sonicavionics/4in/kicad/modules/backplate/production/bom.csv

Designator | Footprint | Quantity | Value | LCSC Part #
J1_5, J1_4, J1_3, J1_2, J1 | AMPHENOL_10018784-10210TLF | 5 | 10018784-10210TLF
R1, R2 | 0805 | 2 | 120
