sonicavionics/4in/kicad/modules/template/production/bom.csv

Designator | Footprint | Quantity | Value | LCSC Part #
J1 | BUS_PCIexpress_x1 | 1 | Bus_PCI_Express_x1 | n/a
