sonicavionics/4in/kicad/backplate.DXF

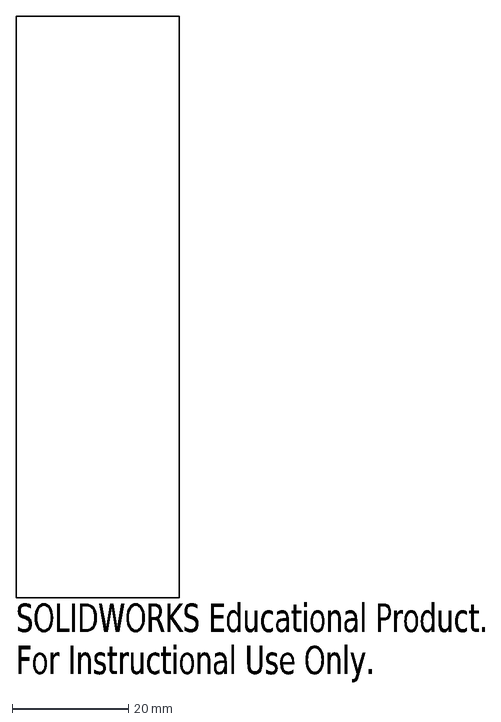
[picture p1: CAD file, 2024-12-09]
kicad/backplate.DXF
SOLIDWORKS Educational Product.
For Instructional Use Only.
