sonicavionics/4in/rack.DXF

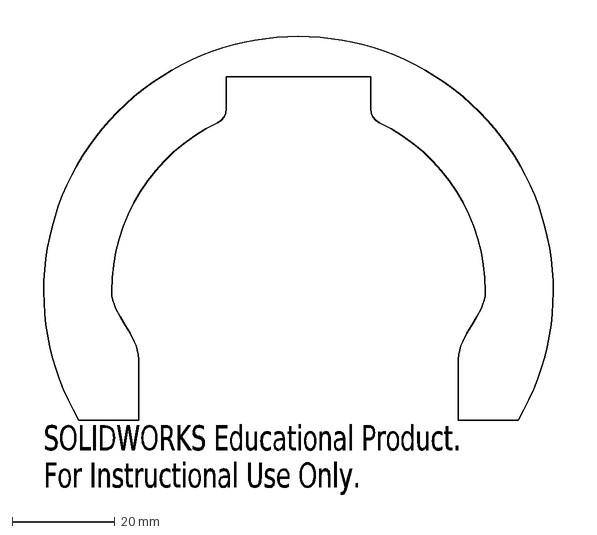
[picture p2: CAD file, 2024-12-08]
rack.DXF
SOLIDWORKS Educational Product.
For Instructional Use Only.
