sonicavionics/4in/kicad/pcb.DXF

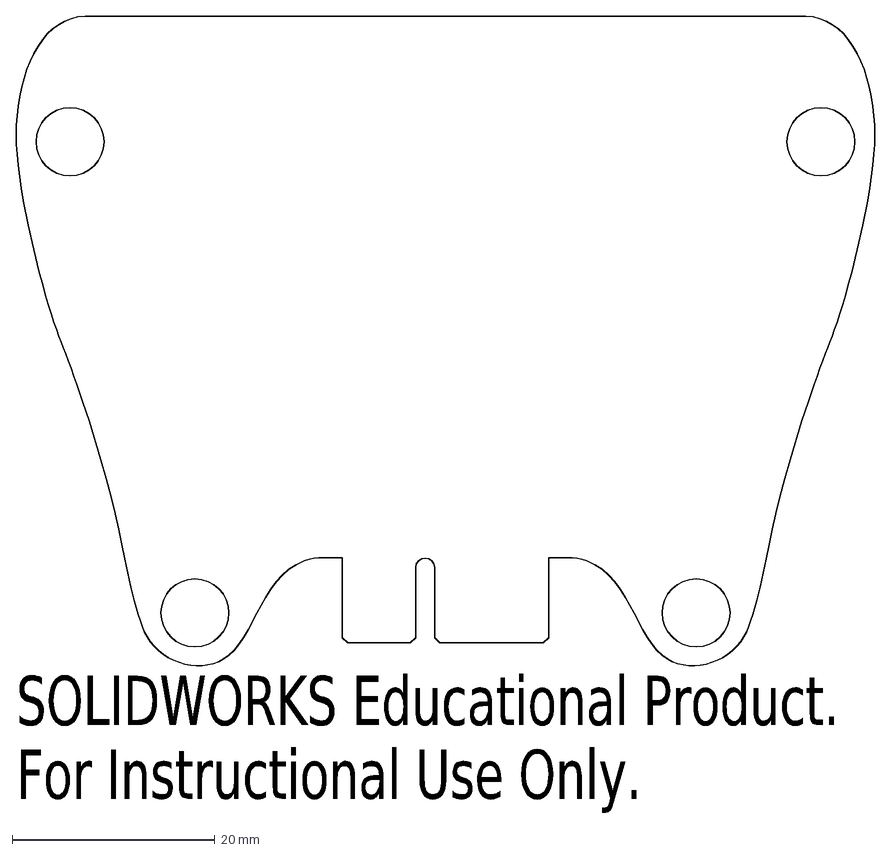
[picture p3: CAD file, 2024-12-09]
kicad/pcb.DXF
SOLIDWORKS Educational Product.
For Instructional Use Only.
