sonicavionics/4in/pcb.DXF

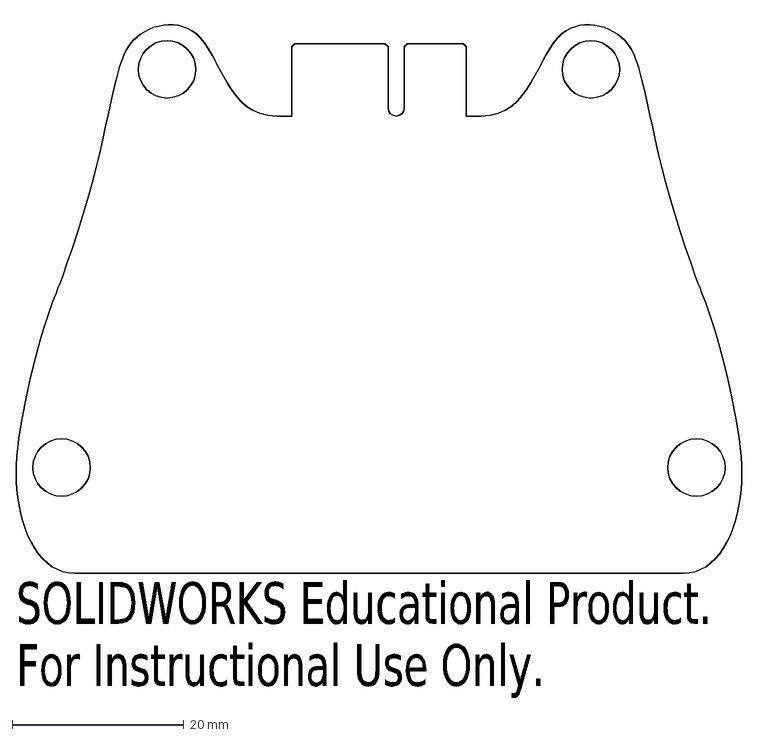
[picture p4: CAD file, 2024-12-08]
pcb.DXF
SOLIDWORKS Educational Product.
For Instructional Use Only.
