sonicavionics/4in/kicad/rack.DXF

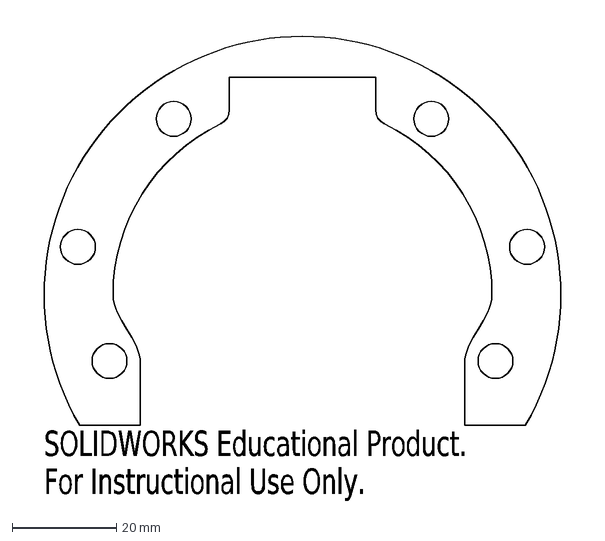
[picture p5: CAD file, 2024-12-09]
kicad/rack.DXF
SOLIDWORKS Educational Product.
For Instructional Use Only.
