sonicavionics/4in/dingboard_solidworks/Assem1.SLDASM

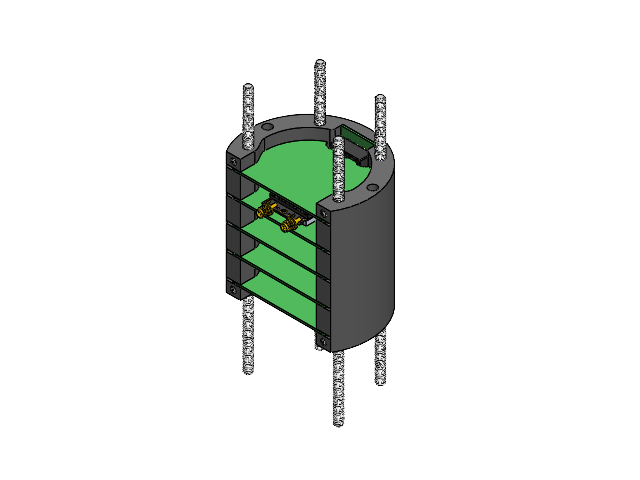
[picture p6: CAD file, 2024-12-08]
dingboard_solidworks/Assem1.SLDASM
board x 5
rack
back_plate
pcie_socket x 5
RFD 900+
insert x 4
3313N126_High-Strength Steel Threaded Rod x 4
