sonicavionics/4in/dingboard_solidworks/Assm.SLDASM

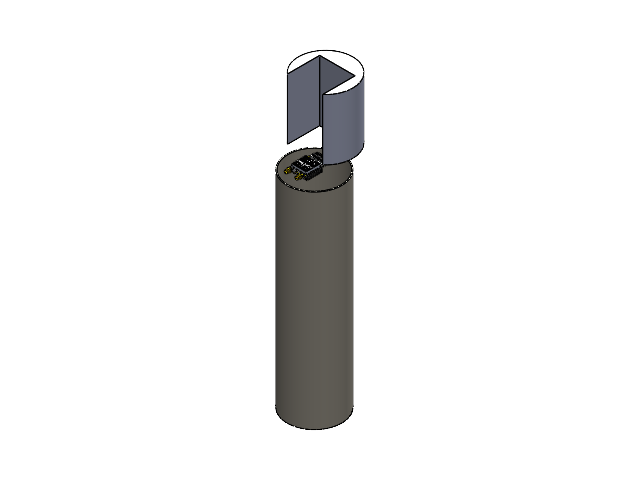
[picture p7: CAD file, 2024-12-04]
dingboard_solidworks/Assm.SLDASM
bipe
RFD 900+
