sonicavionics/4in/kicad/modules/sensors/sensors.kicad_pcb

## KiCad design kicad/modules/sensors/sensors.kicad_pcb (2025-01-03)

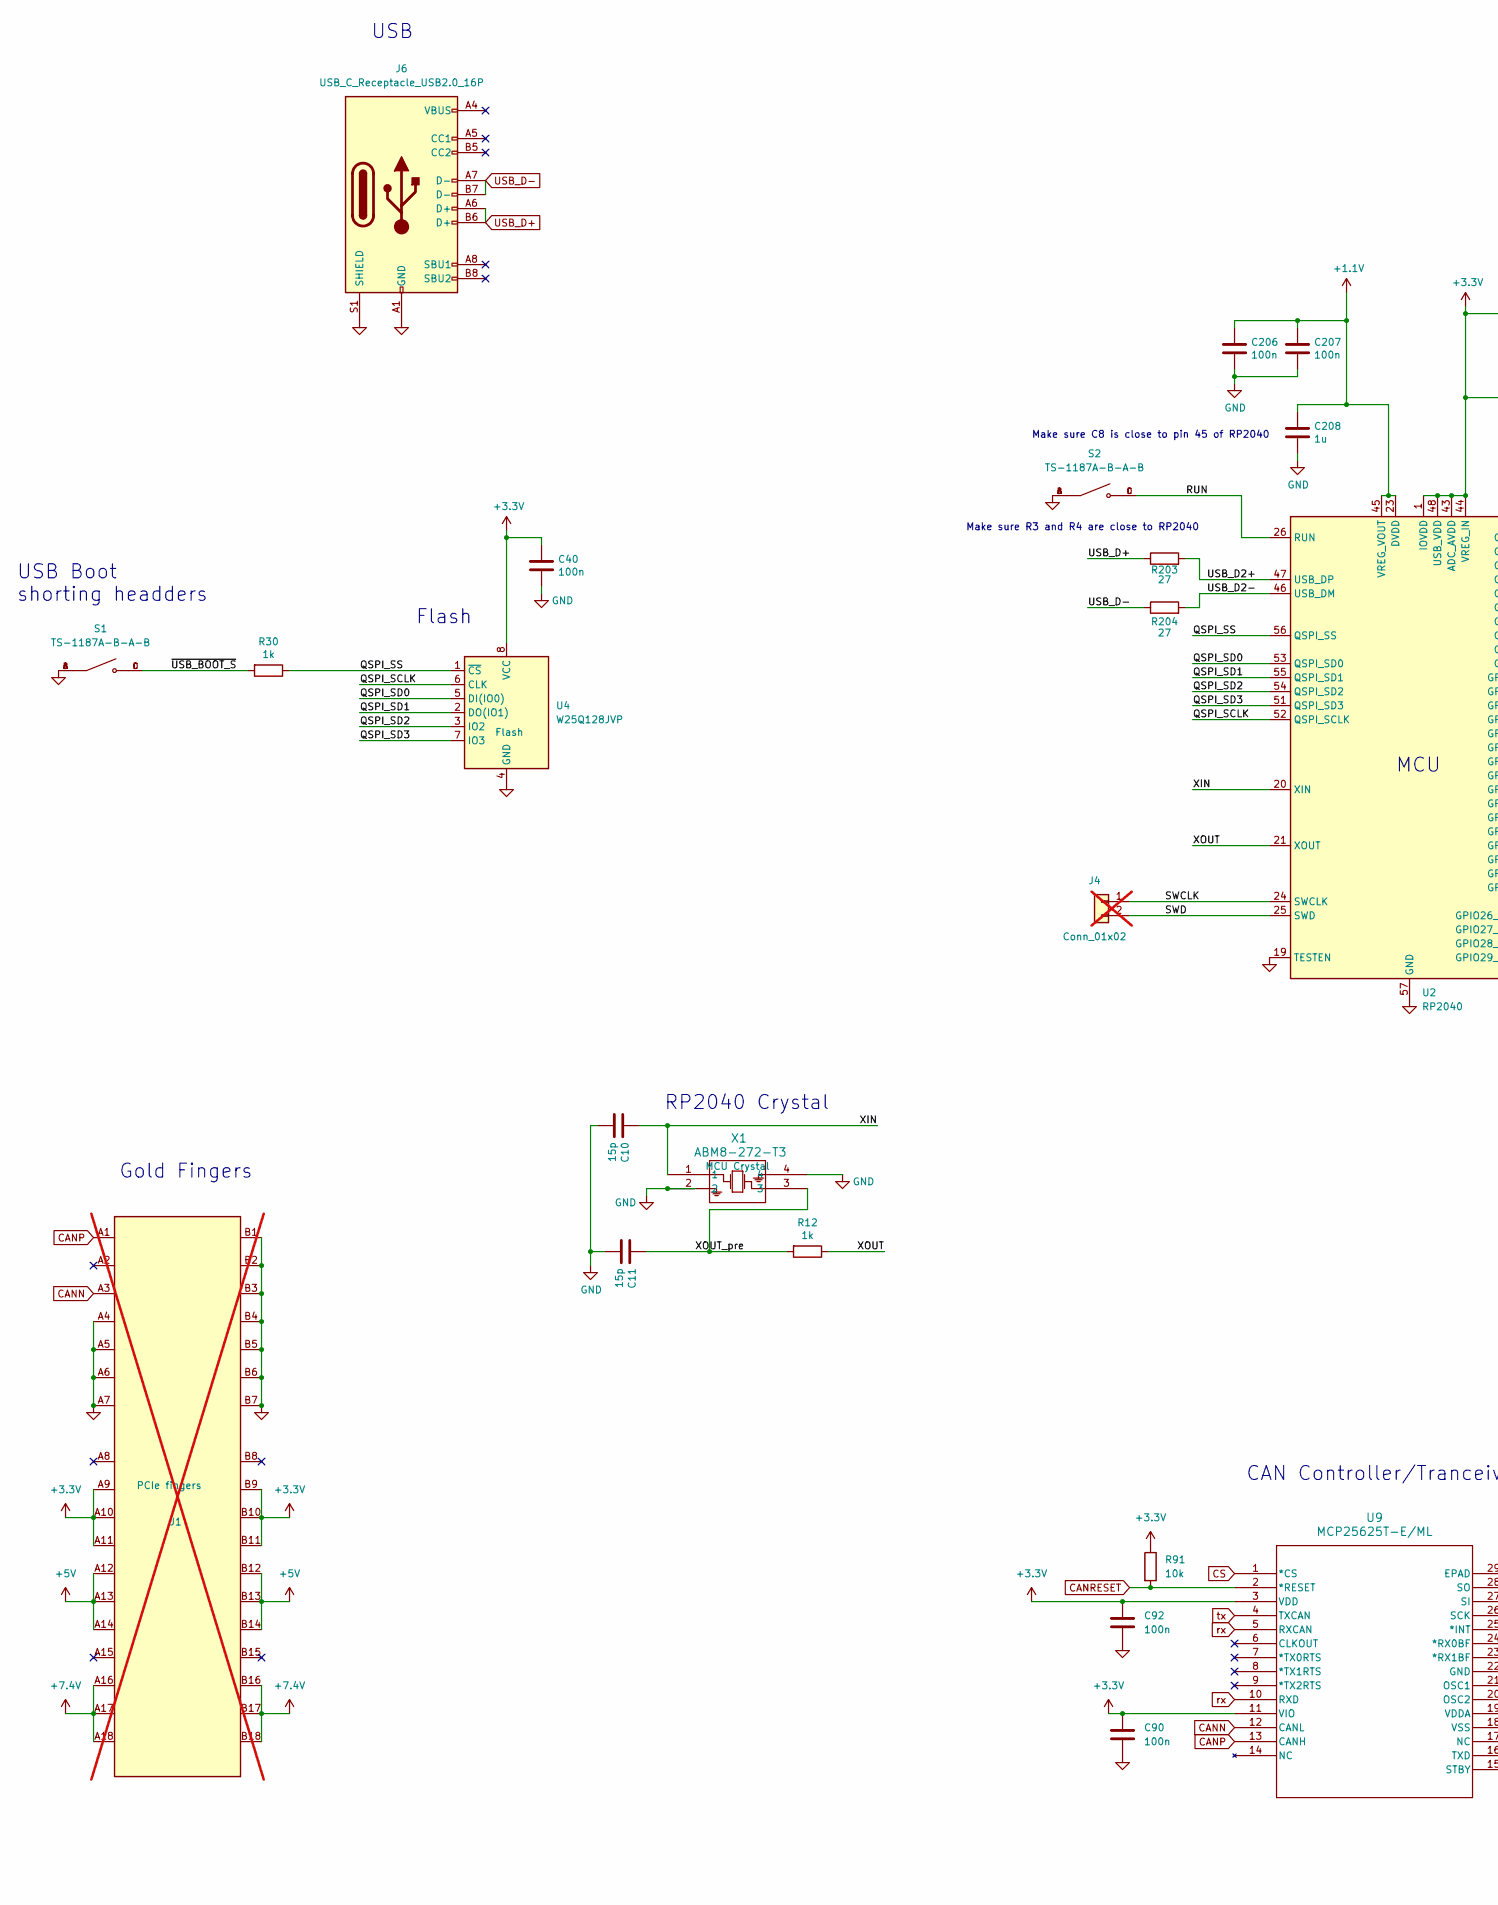
[picture p9: schematic sensors.kicad_sch, part in row 1, column 1]

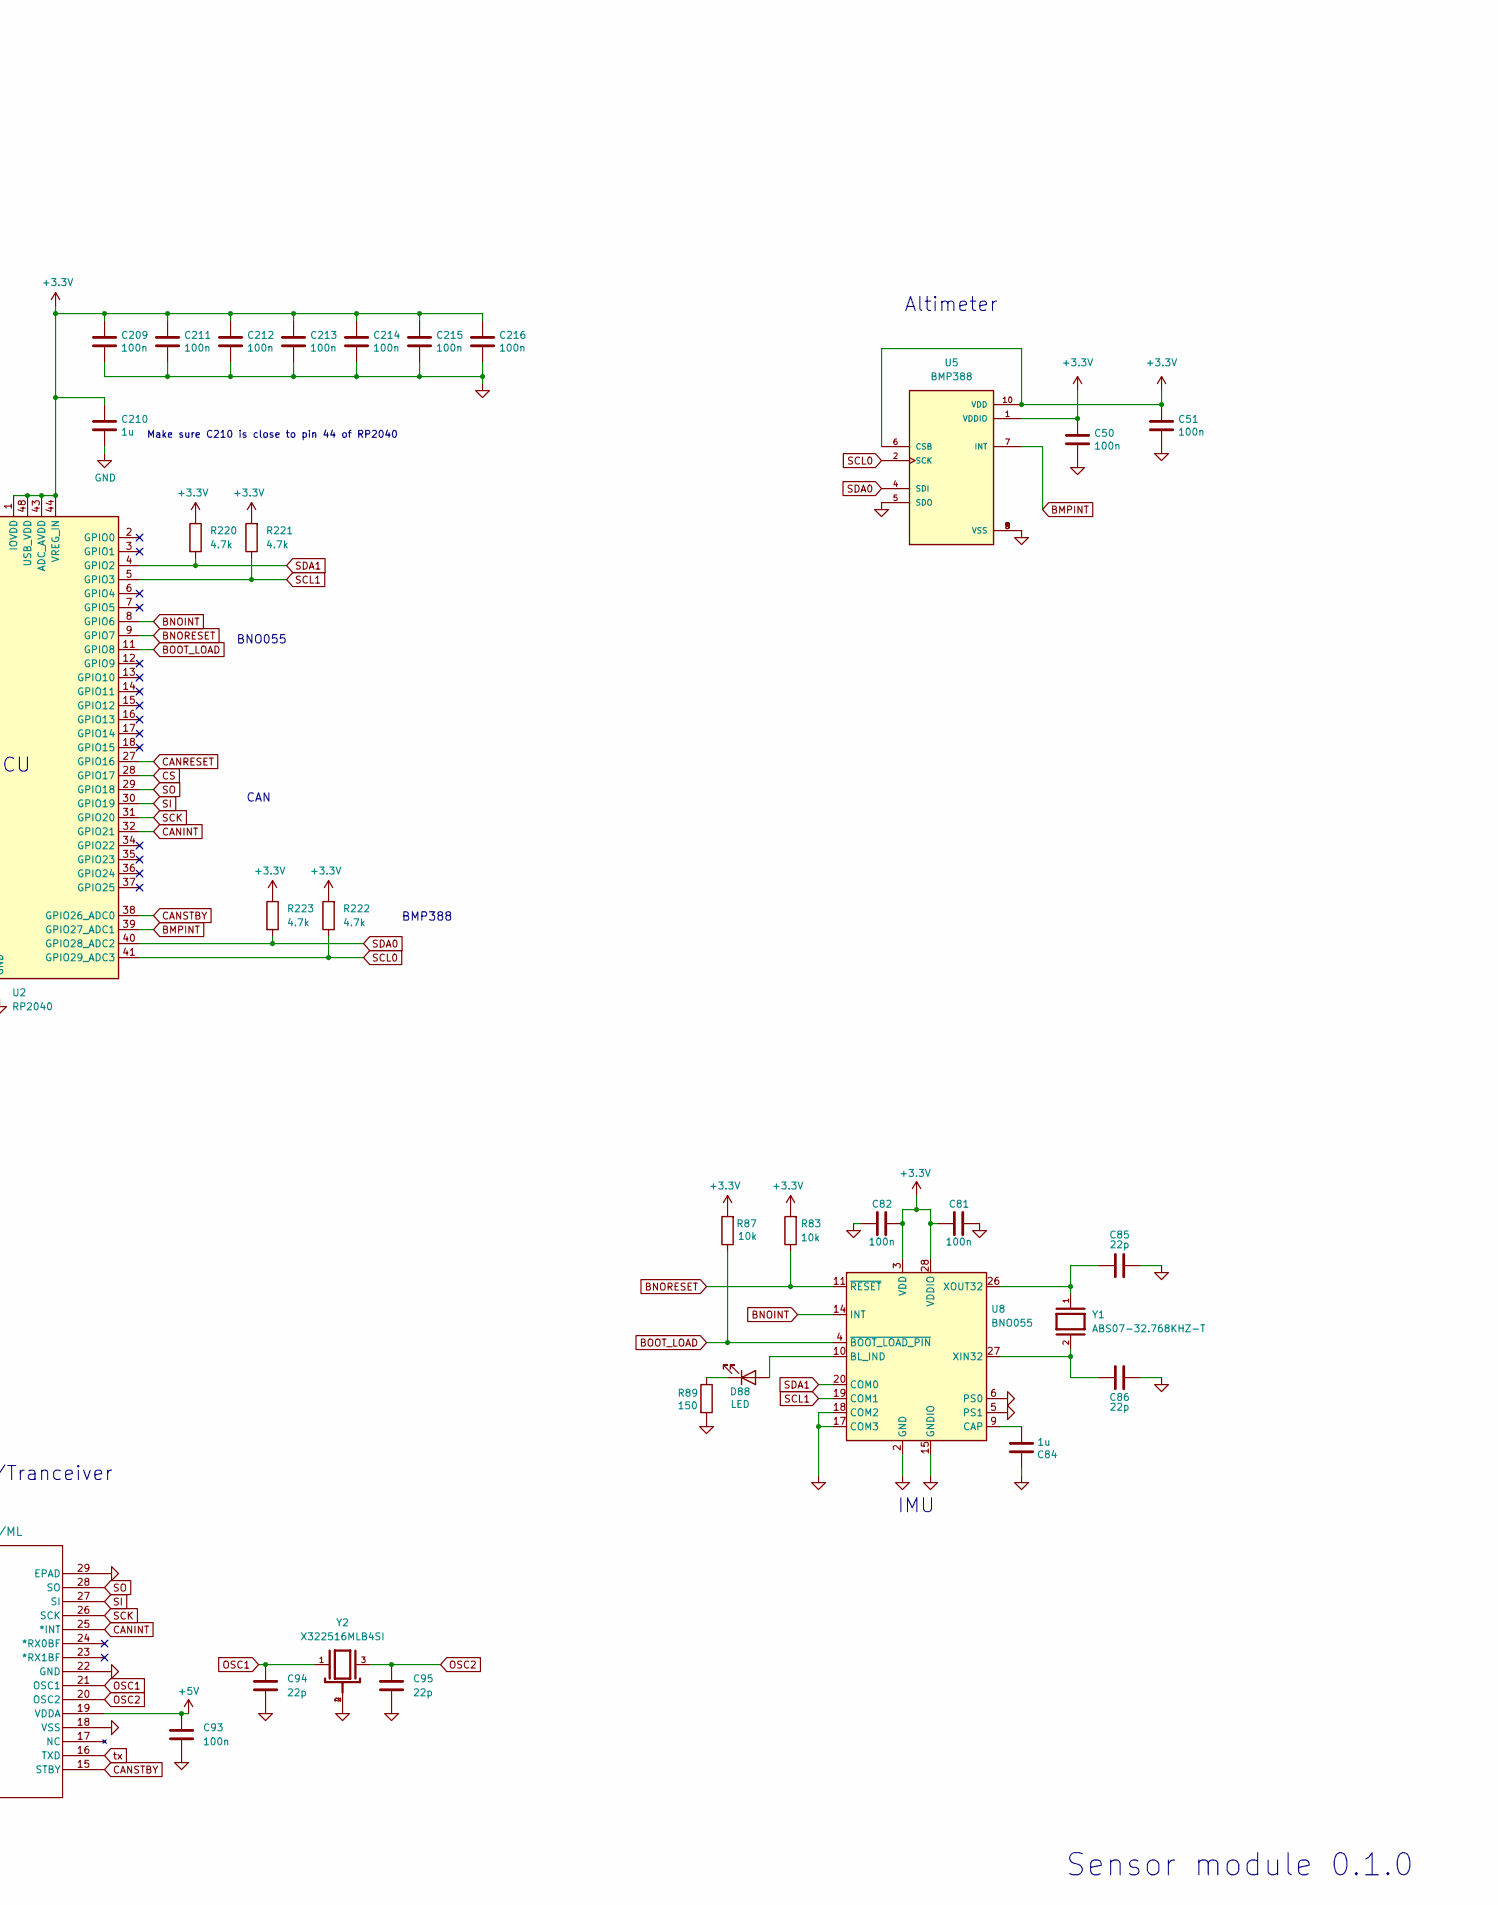
[picture p10: schematic sensors.kicad_sch, part in row 1, column 2]

Parts:
C10, C11: 15p; C_0402_1005Metric; LCSC Part # C1548
C40, C50, C51, C81, C82, C90, C92, C93, C206, C207, C209, C211, C212, C213, C214, C215, C216: 100n; C_0402_1005Metric; LCSC Part # C307331
C84, C208, C210: 1u; C_0402_1005Metric; LCSC Part # C52923
C85, C86, C94, C95: 22p; C_0402_1005Metric; LCSC Part # C1555
D88: LED; LED_0603_1608Metric; LCSC Part # C2286
J1: Bus_PCI_Express_x1; BUS_PCIexpress_x1; LCSC Part # n/a; not fitted
J4: Conn_01x02; PinHeader_1x02_P2.54mm_Vertical; LCSC Part # n/a; not fitted
J6: USB_C_Receptacle_USB2.0_16P; USB_C_Receptacle_Palconn_UTC16-G; LCSC Part # C2765186
R12, R30: 1k; R_0402_1005Metric; LCSC Part # C11702
R83, R87, R91: 10k; R_0402_1005Metric; LCSC Part # C25744
R89: 150; R_0603_1608Metric; LCSC Part # C22808
R203, R204: 27; R_0402_1005Metric; LCSC Part # C25100
R220, R221, R222, R223: 4.7k; R_0402_1005Metric; LCSC Part # C25900
S1, S2: TS-1187A-B-A-B; SW_TS-1187A-B-A-B; PARTREV A0; LCSC Part # C318884
U2: RP2040; QFN-56-1EP_7x7mm_P0.4mm_EP3.2x3.2mm; LCSC C2040
U4: W25Q128JVP; WSON-8-1EP_6x5mm_P1.27mm_EP3.4x4.3mm; LCSC C190862
U5: BMP388; PQFN50P200X200X80-10N; PARTREV 1.1; LCSC Part # C779278
U8: BNO055; LGA-28_5.2x3.8mm_P0.5mm; LCSC C93216
U9: MCP25625T-E/ML; QFN28_6X6MC_MCH; LCSC Part # C191253
X1: ABM8-272-T3; ABM8-272-T3_ABR; LCSC Part # C20625731
Y1: ABS07-32.768KHZ-T; XTAL_ABS07-32.768KHZ-T; PARTREV 08.19.15; LCSC Part # C130253
Y2: X322516MLB4SI; OSC_X322516MLB4SI; PARTREV N/A; LCSC Part # C12668

Connections:
+1.1V: C206.1, C207.1, C208.1, U2.23 (DVDD), U2.45 (VREG_VOUT), U2.50 (DVDD)
+3.3V: C40.1, C50.1, C51.1, C81.1, C82.2, C90.1, C92.1, C209.1, C210.1, C211.1, C212.1, C213.1, C214.1, C215.1, C216.1, J1.A9 (+3.3V), J1.A10 (+3.3V), J1.A11 (~PERST), J1.B9 (JTAG1), J1.B10 (3.3Vaux), J1.B11 (~WAKE), R83.2, R87.2, R91.1, R220.1, R221.2, R222.2, R223.1, U2.1 (IOVDD), U2.10 (IOVDD), U2.22 (IOVDD), U2.33 (IOVDD), U2.42 (IOVDD), U2.43 (ADC_AVDD), U2.44 (VREG_IN), U2.48 (USB_VDD), U2.49 (IOVDD), U4.8 (VCC), U5.1 (VDDIO), U5.6 (CSB), U5.10 (VDD), U8.3 (VDD), U8.28 (VDDIO), U9.3 (VDD), U9.11 (VIO)
+5V: C93.1, J1.A12 (GND), J1.A13 (REFCLK+), J1.A14 (REFCLK-), J1.B12 (RSVD), J1.B13 (GND), J1.B14 (PETp0), U9.19 (VDDA)
+7.4V: J1.A16 (PERp0), J1.A17 (PERn0), J1.A18 (GND), J1.B16 (GND), J1.B17 (~PRSNT2), J1.B18 (GND)
/QSPI_SCLK: U2.52 (QSPI_SCLK), U4.6 (CLK)
/QSPI_SD0: U2.53 (QSPI_SD0), U4.5 (DI(IO0))
/QSPI_SD1: U2.55 (QSPI_SD1), U4.2 (DO(IO1))
/QSPI_SD2: U2.54 (QSPI_SD2), U4.3 (IO2)
/QSPI_SD3: U2.51 (QSPI_SD3), U4.7 (IO3)
/QSPI_SS: R30.1, U2.56 (QSPI_SS), U4.1 (~CS)
/RUN: S2.C, S2.D, U2.26 (RUN)
/SWCLK: J4.1, U2.24 (SWCLK)
/SWD: J4.2, U2.25 (SWD)
/USB_D2+: R203.2, U2.47 (USB_DP)
/USB_D2-: R204.2, U2.46 (USB_DM)
/XIN: C10.1, U2.20 (XIN), X1.1
/XOUT: R12.1, U2.21 (XOUT)
/XOUT_pre: C11.1, R12.2, X1.3
/~USB_BOOT_S: R30.2, S1.C, S1.D
BMPINT: U2.39 (GPIO27_ADC1), U5.7 (INT)
BNOINT: U2.8 (GPIO6), U8.14 (INT)
BNORESET: R83.1, U2.9 (GPIO7), U8.11 (~RESET)
BOOT_LOAD: R87.1, U2.11 (GPIO8), U8.4 (~BOOT_LOAD_PIN)
CANINT: U2.32 (GPIO21), U9.25 (*INT)
CANN: J1.A3 (+12V), U9.12 (CANL)
CANP: J1.A1 (~PRSNT1), U9.13 (CANH)
CANRESET: R91.2, U2.27 (GPIO16), U9.2 (*RESET)
CANSTBY: U2.38 (GPIO26_ADC0), U9.15 (STBY)
CS: U2.28 (GPIO17), U9.1 (*CS)
GND: C10.2, C11.2, C40.2, C50.2, C51.2, C81.2, C82.1, C84.1, C85.2, C86.1, C90.2, C92.2, C93.2, C94.2, C95.2, C206.2, C207.2, C208.2, C209.2, C210.2, C211.2, C212.2, C213.2, C214.2, C215.2, C216.2, J1.A4 (GND), J1.A5 (JTAG2), J1.A6 (JTAG3), J1.A7 (JTAG4), J1.B1 (+12V), J1.B2 (+12V), J1.B3 (+12V), J1.B4 (GND), J1.B5 (SMCLK), J1.B6 (SMDAT), J1.B7 (GND), J6.A1 (GND), J6.A12 (GND), J6.B1 (GND), J6.B12 (GND), J6.S1 (SHIELD), R89.2, S1.A, S1.B, S2.A, S2.B, U2.19 (TESTEN), U2.57 (GND), U4.4 (GND), U5.3 (VSS), U5.5 (SDO), U5.8 (VSS), U5.9 (VSS), U8.2 (GND), U8.5 (PS1), U8.6 (PS0), U8.15 (GNDIO), U8.16 (GNDIO), U8.17 (COM3), U8.18 (COM2), U8.25 (GNDIO), U9.18 (VSS), U9.22 (GND), U9.29 (EPAD), X1.2, X1.4, Y2.2, Y2.4
unnamed: D88.2 (A), U8.10 (BL_IND)
unnamed: D88.1 (K), R89.1
unnamed: C84.2, U8.9 (CAP)
unnamed: C86.2, U8.27 (XIN32), Y1.2
unnamed: C85.1, U8.26 (XOUT32), Y1.1
OSC1: C94.1, U9.21 (OSC1), Y2.1
OSC2: C95.1, U9.20 (OSC2), Y2.3
SCK: U2.31 (GPIO20), U9.26 (SCK)
SCL0: R222.1, U2.41 (GPIO29_ADC3), U5.2 (SCK)
SCL1: R221.1, U2.5 (GPIO3), U8.19 (COM1)
SDA0: R223.2, U2.40 (GPIO28_ADC2), U5.4 (SDI)
SDA1: R220.2, U2.4 (GPIO2), U8.20 (COM0)
SI: U2.30 (GPIO19), U9.27 (SI)
SO: U2.29 (GPIO18), U9.28 (SO)
USB_D+: J6.A6 (D+), J6.B6 (D+), R203.1
USB_D-: J6.A7 (D-), J6.B7 (D-), R204.1
rx: U9.5 (RXCAN), U9.10 (RXD)
tx: U9.4 (TXCAN), U9.16 (TXD)

Notes on the sheet:
Make sure C210 is close to pin 44 of RP2040
Make sure C8 is close to pin 45 of RP2040
RP2040 Crystal
Altimeter
BNO055
BMP388
IMU
USB
Make sure R3 and R4 are close to RP2040
CAN
USB Boot shorting headders
Sensor module 0.1.0
Gold Fingers
MCU
CAN Controller/Tranceiver
Flash

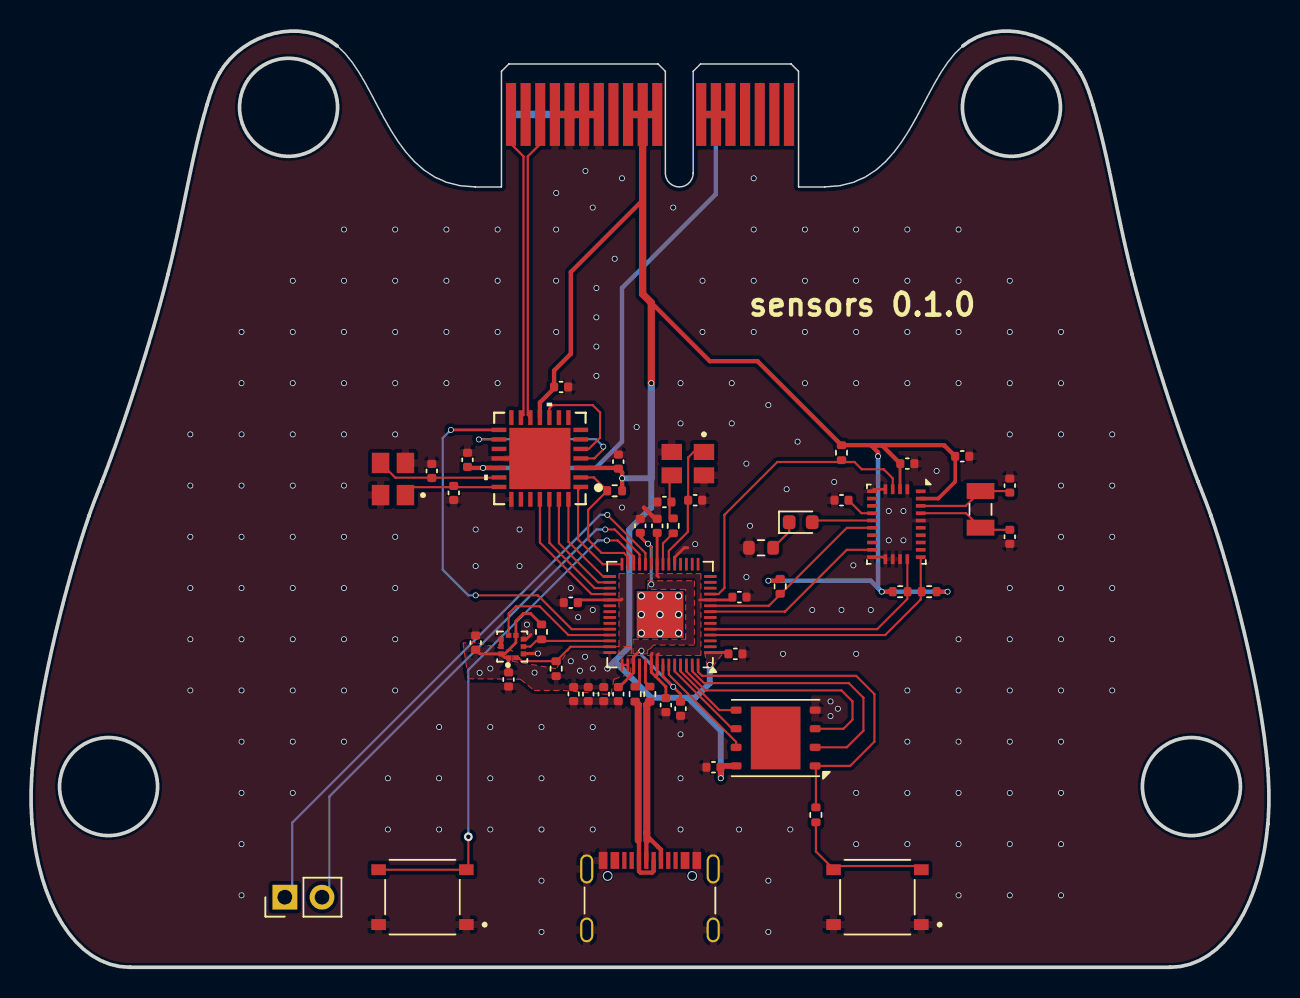
[picture p11: board sensors.kicad_pcb from above]

Board: 2 copper layers, 84.6 x 64.0 mm, 52 parts (1 on the bottom side), 48 nets.
