sonicavionics/4in/kicad/modules/powersim/powersim.kicad_pcb

## KiCad design kicad/modules/powersim/powersim.kicad_pcb (2025-01-03)

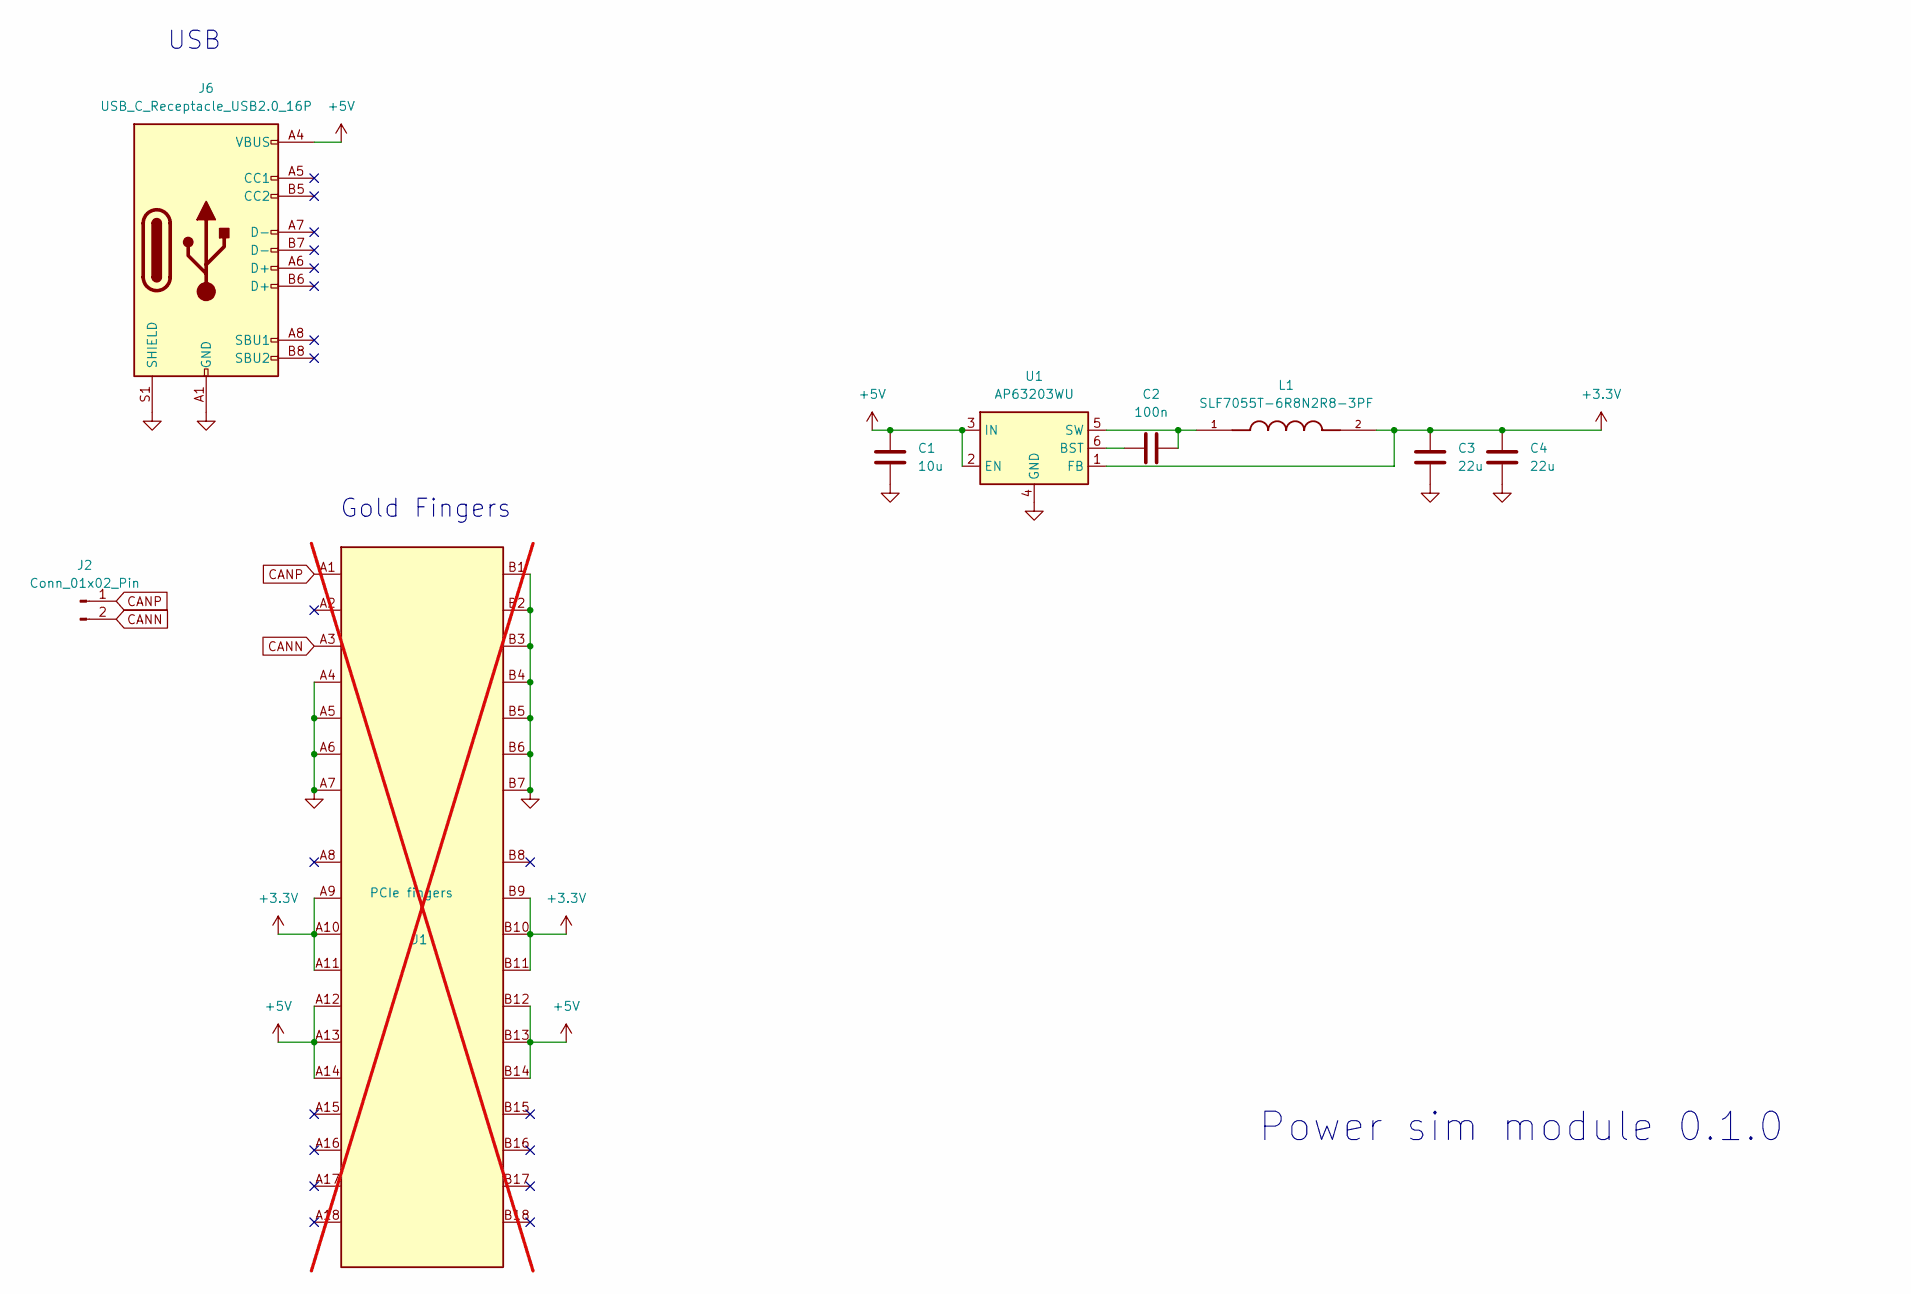
[picture p12: schematic powersim.kicad_sch]

Parts:
C1: 10u; C_0402_1005Metric; LCSC Part # C15525
C2: 100n; C_0402_1005Metric; LCSC Part # C307331
C3, C4: 22u; C_0603_1608Metric; LCSC Part # C59461
J1: Bus_PCI_Express_x1; BUS_PCIexpress_x1; LCSC Part # n/a; not fitted
J2: Conn_01x02_Pin; PinHeader_1x02_P2.54mm_Vertical
J6: USB_C_Receptacle_USB2.0_16P; USB_C_Receptacle_Palconn_UTC16-G; LCSC Part # C2765186
L1: SLF7055T-6R8N2R8-3PF; IND_SLF7055T-6R8N2R8-3PF; PARTREV N/A; LCSC Part # C21218
U1: AP63203WU; TSOT-23-6; LCSC Part # C780769

Connections:
+3.3V: C3.1, C4.1, J1.A9 (+3.3V), J1.A10 (+3.3V), J1.A11 (~PERST), J1.B9 (JTAG1), J1.B10 (3.3Vaux), J1.B11 (~WAKE), L1.2, U1.1 (FB)
+5V: C1.1, J1.A12 (GND), J1.A13 (REFCLK+), J1.A14 (REFCLK-), J1.B12 (RSVD), J1.B13 (GND), J1.B14 (PETp0), J6.A4 (VBUS), J6.A9 (VBUS), J6.B4 (VBUS), J6.B9 (VBUS), U1.2 (EN), U1.3 (IN)
CANN: J1.A3 (+12V), J2.2
CANP: J1.A1 (~PRSNT1), J2.1
GND: C1.2, C3.2, C4.2, J1.A4 (GND), J1.A5 (JTAG2), J1.A6 (JTAG3), J1.A7 (JTAG4), J1.B1 (+12V), J1.B2 (+12V), J1.B3 (+12V), J1.B4 (GND), J1.B5 (SMCLK), J1.B6 (SMDAT), J1.B7 (GND), J6.A1 (GND), J6.A12 (GND), J6.B1 (GND), J6.B12 (GND), J6.S1 (SHIELD), U1.4 (GND)
unnamed: C2.1, U1.6 (BST)
unnamed: C2.2, L1.1, U1.5 (SW)

Notes on the sheet:
USB
Power sim module 0.1.0
Gold Fingers

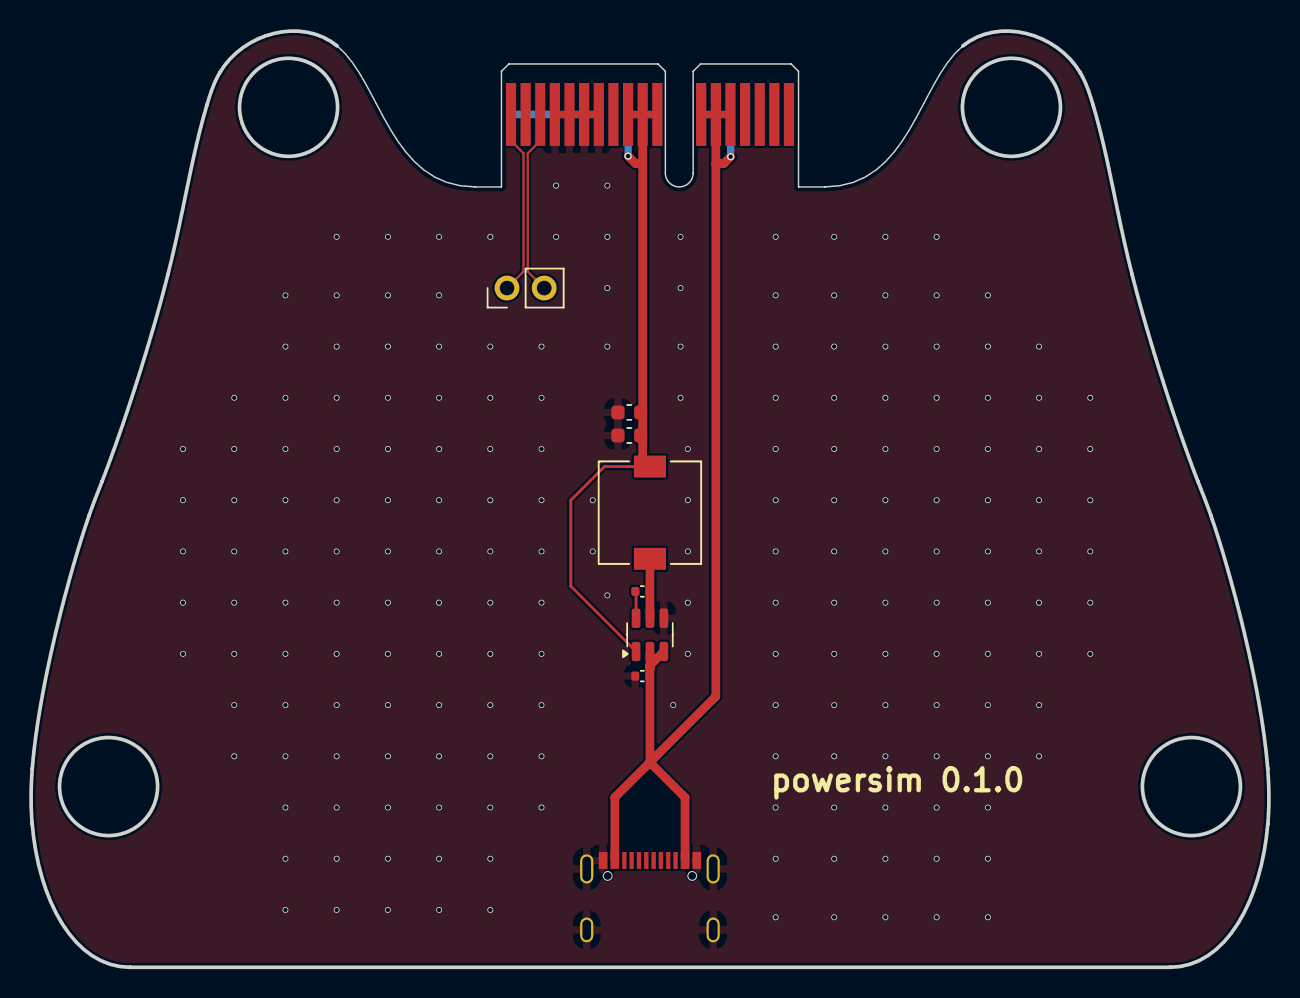
[picture p13: board powersim.kicad_pcb from above]

Board: 2 copper layers, 84.6 x 64.0 mm, 9 parts (1 on the bottom side), 7 nets.
