sonicavionics/4in/kicad/modules/power/power.kicad_pcb

## KiCad design kicad/modules/power/power.kicad_pcb (2024-12-09)

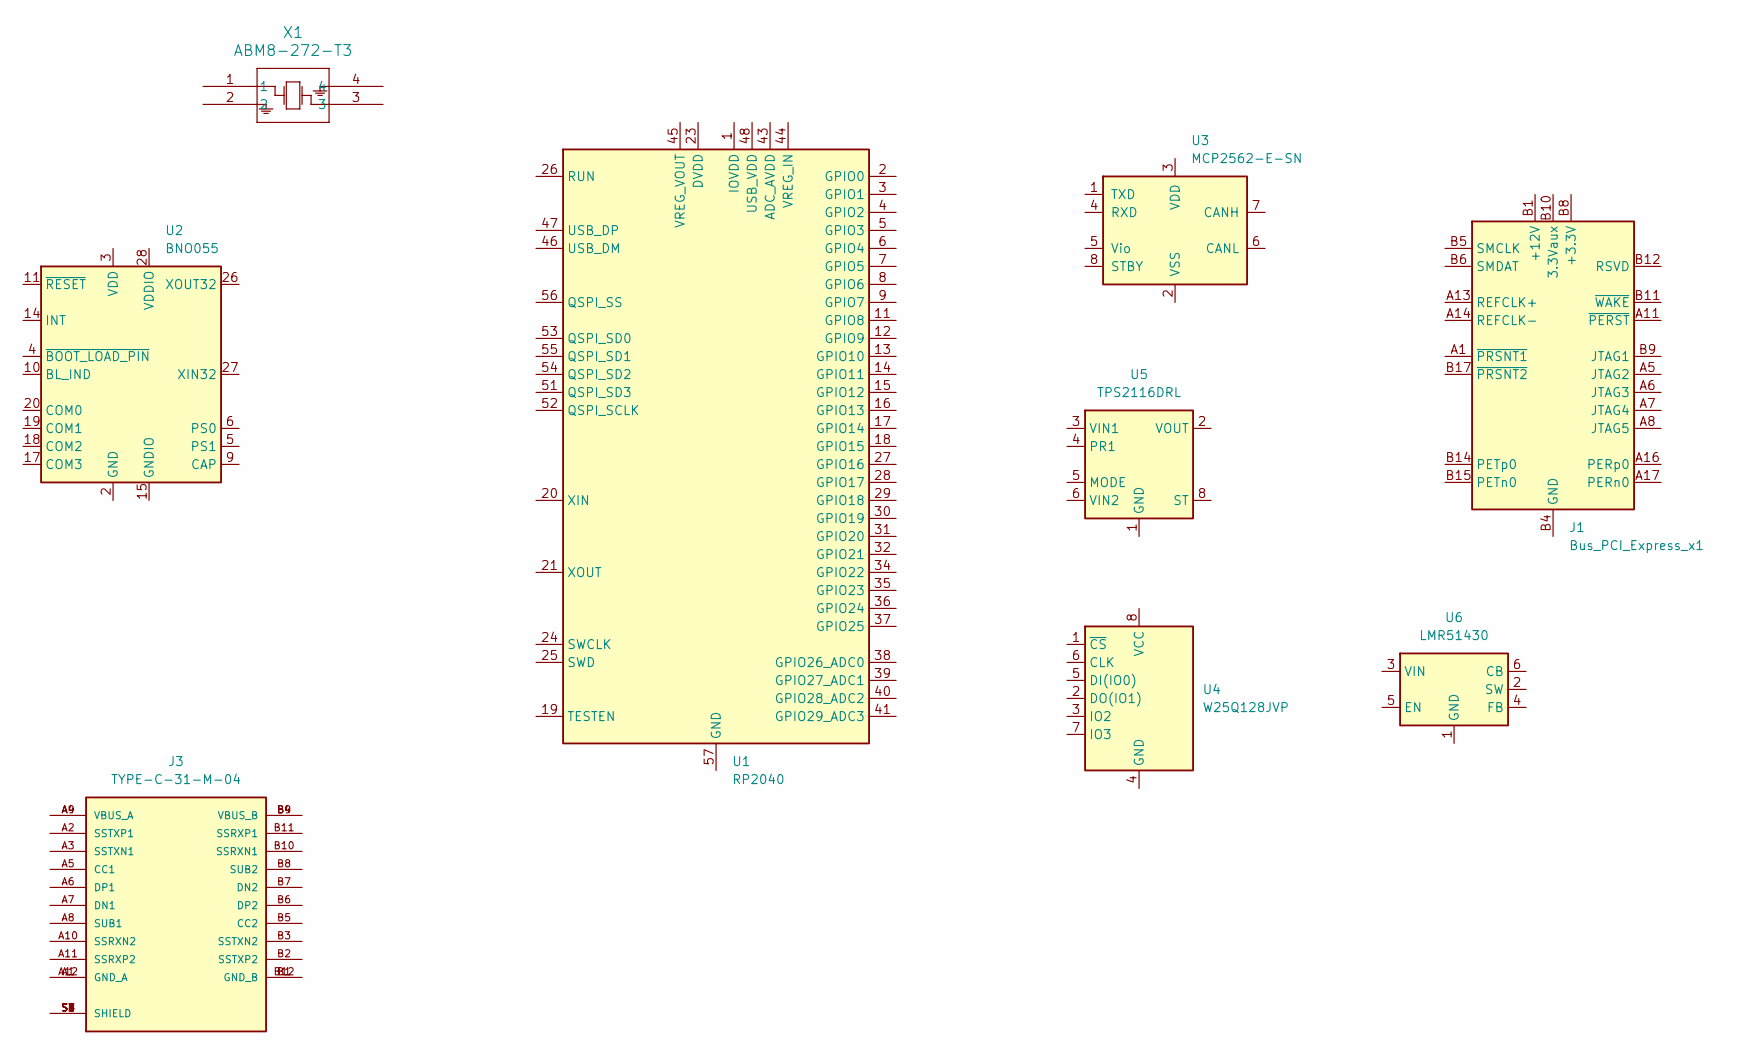
[picture p14: schematic power.kicad_sch]

Parts:
J1: Bus_PCI_Express_x1; BUS_PCIexpress_x1; LCSC n/a
J3: TYPE-C-31-M-04; HRO_TYPE-C-31-M-04; PARTREV A; LCSC C129018
U1: RP2040; QFN-56-1EP_7x7mm_P0.4mm_EP3.2x3.2mm; LCSC C2040
U2: BNO055; LGA-28_5.2x3.8mm_P0.5mm; LCSC C93216
U3: MCP2562-E-SN; SOIC-8_3.9x4.9mm_P1.27mm
U4: W25Q128JVP; WSON-8-1EP_6x5mm_P1.27mm_EP3.4x4.3mm; LCSC C190862
U5: TPS2116DRL; SOT-583-8
U6: LMR51430; SOT-23-6
X1: ABM8-272-T3; ABM8-272-T3_ABR

Connections:
unnamed: J1.A9 (+3.3V), J1.A10 (+3.3V), J1.B8 (+3.3V)
unnamed: J1.A2 (+12V), J1.A3 (+12V), J1.B1 (+12V), J1.B2 (+12V), J1.B3 (+12V)
unnamed: J1.A4 (GND), J1.A12 (GND), J1.A15 (GND), J1.A18 (GND), J1.B4 (GND), J1.B7 (GND), J1.B13 (GND), J1.B16 (GND), J1.B18 (GND)
unnamed: J3.A1 (GND_A), J3.A12 (GND_A)
unnamed: J3.B1 (GND_B), J3.B12 (GND_B)
unnamed: J3.S1 (SHIELD), J3.S2 (SHIELD), J3.S3 (SHIELD), J3.S4 (SHIELD), J3.S5 (SHIELD), J3.S6 (SHIELD), J3.S7 (SHIELD), J3.S8 (SHIELD)
unnamed: J3.A4 (VBUS_A), J3.A9 (VBUS_A)
unnamed: J3.B4 (VBUS_B), J3.B9 (VBUS_B)
unnamed: U1.23 (DVDD), U1.50 (DVDD)
unnamed: U1.1 (IOVDD), U1.10 (IOVDD), U1.22 (IOVDD), U1.33 (IOVDD), U1.42 (IOVDD), U1.49 (IOVDD)
unnamed: U2.15 (GNDIO), U2.16 (GNDIO), U2.25 (GNDIO)
unnamed: U5.2 (VOUT), U5.7 (VOUT)

Board: 2 copper layers, 9 parts (0 on the bottom side), 12 nets, no tracks yet.
