sonicavionics/4in/(commit log)

2024-11-17 add RT9080-33GJ5
    [1power.SchDoc]
2024-11-17 begin adding chips
    [1power.SchDoc, 2mcu.SchDoc, PCB1.PcbDoc, dingboard_altium.PrjPcb]
2024-11-17 add rp2040 library
    [1power.SchDoc, 2mcu.SchDoc, PCB1.PcbDoc, dingboard_altium.PrjPcb]
2024-11-18 nov 17 save
    [1power.SchDoc, 2mcu.SchDoc, PCB1.PcbDoc, dingboard_altium.PrjPcb]
2024-11-19 begin protection ic schematic
    [1power.SchDoc, PCB1.PcbDoc, dingboard_altium.PrjPcb]
2024-11-20 complete battery protection IC
    [1power.SchDoc, 2mcu.SchDoc, PCB1.PcbDoc, PcbLib1.PcbLib, Schlib1.SchLib, dingboard_altium.PrjPcb]
2024-11-20 refactor folders
    [Components - 17.11.24 - 13.39.PcbLib, Components - 17.11.24 - 13.39.SchLib]
2024-11-20 auto annotate
    [1power.SchDoc]
2024-11-21 update BOM
2024-11-21 finish charger/switching IC
    [1power.SchDoc, PCB1.PcbDoc]
2024-11-21 finish buck boost
    [1power.SchDoc, 2mcu.SchDoc, PCB1.PcbDoc]
2024-11-21 add fuel guage
    [1power.SchDoc, 2mcu.SchDoc, PCB1.PcbDoc, dingboard_altium.PrjPcb]
2024-11-21 start PCB layout
    [1power.SchDoc, PCB1.PcbDoc]
2024-11-22 refactor fuel guage
    [1power.SchDoc, PCB1.PcbDoc]
2024-11-22 add design rules from JLC
    [1power.SchDoc, PCB1.PcbDoc]
2024-11-22 refactor charger/switch
    [1power.SchDoc, PCB1.PcbDoc]
2024-11-22 change all components to 0402 from 0603
    [1power.SchDoc, PCB1.PcbDoc]
2024-11-25 route switching/charging ic
    [1power.SchDoc, PCB1.PcbDoc, dingboard_altium.PrjPcb]
2024-11-25 route battery protection ic
    [1power.SchDoc, PCB1.PcbDoc]
2024-11-26 add gold fingers
    [1power.SchDoc, 2mcu.SchDoc, PCB1.PcbDoc, PcbLib1.PcbLib, Schlib1.SchLib]
2024-12-01 reclaim project from altium 365
    [1power.SchDoc, 2mcu.SchDoc, DRC0010J_V_CMP-0347-00023-2.x_t, FP-ASMD-CWG7-NX7D2-MFG_CMP-02129-107448438-1.x_t, FP-C0402C105K8PACTU-MFG_CMP-2008-02081-2.x_t, FP-C1005-050-0_05-IPC_B_CMP-2000-06003-2.x_t, FP-CRCW0402-e3-IPC_A_CMP-1011-00590-4.x_t, FP-CRCW0402-e3-IPC_A_CMP-2002-08575-2.x_t]
2024-12-01 save outjob files
    [dingboard_altium.PrjPcb]
2024-12-02 generate fab files
    [1power.SchDoc, PCB1.PcbDoc]
2024-12-02 fix LED polarity, add top silkscreen to clairify pin 1 on all ICs, add back missing via, update version number.
    [1power.SchDoc, PCB1.PcbDoc, Part1.SLDPRT]
2024-12-02 add spacing to vias
    [PCB1.PcbDoc]
2024-12-04 add solidworks files, update outjob file
    [1power.SchDoc, PCB1.PcbDoc, avionics_bulkhead.SLDPRT, dingboard_altium.PrjPcb]
2024-12-04 init new CAD files
    [Assm.SLDASM, RFD 900+.SLDPRT, bipe.SLDPRT]
2024-12-04 begin assembly for avionics bay
    [Part1.SLDPRT, bipe.SLDPRT]
2024-12-04 init backplate assembly
    [18650.SLDPRT, Part1.SLDPRT, back_plate.SLDPRT, backplate.SLDASM, bipe.SLDPRT, pcie_socket.SLDPRT, rack.SLDPRT]
2024-12-04 set variables to dynamically update card number
    [back_cover.SLDPRT, back_plate.SLDPRT, backplate.SLDASM, bipe.SLDPRT, pcie_socket.SLDPRT, rack.SLDPRT]
2024-12-05 finish first revision of avionics bay
    [Part3.SLDPRT, back_cover.SLDPRT, back_plate.SLDPRT, backplate.SLDASM, bipe.SLDPRT, board.SLDPRT, pcie_socket.SLDPRT, rack.SLDPRT]
2024-12-06 swtich to circular design to fit the RFD 900
    [back_cover.SLDPRT, back_plate.SLDPRT, backplate.SLDASM, bananajack.SLDPRT, bananaplug.SLDPRT, bipe.SLDPRT, board.SLDPRT, front_cover.SLDPRT]
2024-12-06 complete finish new avionics template
    [RFD 900+.SLDPRT, back_plate.SLDPRT, backplate.SLDASM, bipe.SLDPRT, board.SLDPRT, frontcover.SLDPRT, rack.SLDPRT]
2024-12-08 finalize avionics bay design
    [3313N126_High-Strength Steel Threaded Rod.SLDPRT, Assem1.SLDASM, back_cover.SLDPRT, back_plate.SLDPRT, backplate.SLDASM, batteryrack.SLDPRT, bipe.SLDPRT, board.SLDPRT]
2024-12-08 clean up
    [Assem1.SLDASM, back_plate.SLDPRT, backplate.SLDASM, bipe.SLDPRT, board.SLDPRT, frontcover.SLDPRT, rack.SLDPRT]
2024-12-08 output dxf files for ECAD
    [Assem1.SLDASM, back_plate.SLDPRT, backplate.SLDASM, bipe.SLDPRT, board.SLDPRT, frontcover.SLDPRT, pcb.DXF, power.kicad_pcb]
2024-12-09 init kicad
    [bom.csv, power.kicad_pcb, power.kicad_sch]
2024-12-09 update DXF files
    [pcb.DXF, rack.DXF]
2024-12-09 add reference step file from kicad PCIe
    [power.kicad_pcb, power.kicad_sch, reference_pcb.step]
2024-12-09 update PCIe port to match KiCad footprint
    [backplate.SLDASM, board.SLDPRT, frontcover.SLDPRT, rack.SLDPRT]
2024-12-09 update DXF files from solidworks
    [backplate.SLDASM, pcb.DXF, rack.DXF]
2024-12-09 add components to kicad power module
    [power.kicad_pcb, power.kicad_sch]
2024-12-09 revert back pcie to right side short
    [backplate.SLDASM, board.SLDPRT, frontcover.SLDPRT, pcb.DXF, rack.SLDPRT]
2024-12-09 add backplate dxf file
    [backplate.DXF]
2024-12-09 create kicad template
    [backplate.kicad_pcb, backplate.kicad_sch, bom.csv, designators.csv, power.kicad_pcb, power.kicad_sch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]
2024-12-12 place BME680 in dingboard sensors schematic
    [backplate.kicad_pcb, backplate.kicad_sch, bom.csv, designators.csv, positions.csv, sensors.kicad_pcb, sensors.kicad_sch, template.kicad_pcb]
2024-12-13 update BOM with new chip list
    [bom.csv, sensors.kicad_pcb, sensors.kicad_sch]
2024-12-15 update BNO055 schematic
    [bom.csv, designators.csv, positions.csv, sensors.kicad_pcb, sensors.kicad_sch]
2024-12-15 add 5v buck-boost for CAN chip
    [sensors.kicad_pcb, sensors.kicad_sch]
2024-12-15 export pdf of schematic
2024-12-17 remove mux over volt protection
    [sensors.kicad_pcb]
2024-12-18 add current estimation to BOM
    [sensors.kicad_sch]
2024-12-18 update gitignore to include kicad files
2024-12-23 switch to Sonic Avionics
    [bom.csv, sensors.kicad_sch]
2024-12-23 update capacitors for basic assembly, export new schematic PDF
    [sensors.kicad_sch]
2024-12-24 remove dingboard from names
    [18650.SLDPRT, 1power.SchDoc, 2mcu.SchDoc, 3313N126_High-Strength Steel Threaded Rod.SLDPRT, Components - 17.11.24 - 13.39.PcbLib, Components - 17.11.24 - 13.39.SchLib, DRC0010J_V_CMP-0347-00023-2.x_t, FP-ASMD-CWG7-NX7D2-MFG_CMP-02129-107448438-1.x_t]
2024-12-24 add kicad footprint library submodule
    [backplate.kicad_pcb, backplate.kicad_sch, bom.csv, designators.csv, positions.csv, power.kicad_pcb, power.kicad_sch, sensors.kicad_pcb]
2024-12-24 move template to modules folder
    [bom.csv, designators.csv, template.kicad_pcb, template.kicad_sch]
2024-12-24 add all project specific footprints
2024-12-24 update symbol library to use project specific library
    [sensors.kicad_pcb, sensors.kicad_sch]
2024-12-26 add no connect to USB power pins
    [sensors.kicad_sch]
2024-12-26 reassign PCIe pins
    [sensors.kicad_sch]
2024-12-26 fix voltage labels
    [sensors.kicad_sch]
2024-12-26 add momentary buttons to schematic
    [sensors.kicad_sch]
2024-12-26 begin routing
    [sensors.kicad_pcb, sensors.kicad_sch]
2024-12-26 continue routing
    [sensors.kicad_pcb]
2024-12-27 finish most routing
    [bom.csv, designators.csv, positions.csv, sensors.kicad_pcb, sensors.kicad_sch]
2024-12-29 change USB-C connector
    [sensors.kicad_pcb, sensors.kicad_sch]
2024-12-30 mod ground planes
    [sensors.kicad_pcb]
2024-12-30 route under rp2040
    [sensors.kicad_pcb, sensors.kicad_sch]
2024-12-30 complete all routing connections, and planes
    [sensors.kicad_pcb, sensors.kicad_sch]
2024-12-31 refine routing
    [sensors.kicad_pcb, sensors.kicad_sch]
2025-01-01 finish diff pairs and planes
    [bom.csv, designators.csv, positions.csv, sensors.kicad_pcb, sensors.kicad_sch]
2025-01-01 Sensors (#4)
    * delete regs and mux
    * add no connect to USB power pins
    * reassign PCIe pins
    * fix voltage labels
    * add momentary buttons to schematic
    * begin routing
    * continue routing
    * finish most routing
    * change USB-C connector
    * mod ground planes
    * route under rp2040
    * complete all routing connections, and planes
    * refine routing
    * finish diff pairs and planes
    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
    [bom.csv, designators.csv, positions.csv, sensors.kicad_pcb, sensors.kicad_sch]
2025-01-01 Sensors (#5)
    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
2025-01-01 update PCIe nets
    [backplate.kicad_sch]
2025-01-01 backplate: update PCIe pins
    [backplate.kicad_pcb, backplate.kicad_sch]
2025-01-01 sensors: update PCIe pin nets, refine routing
    [sensors.kicad_pcb, sensors.kicad_sch]
2025-01-02 backplate: finish initial revision
    [backplate.kicad_pcb, backplate.kicad_sch]
2025-01-02 init powersim module
    [powersim.kicad_pcb, powersim.kicad_sch]
2025-01-02 powersim: add all components to schematic
    [powersim.kicad_pcb, powersim.kicad_sch]
2025-01-02 sensors: update BOM
    [bom.csv]
2025-01-02 powersim: resize schematic page
    [powersim.kicad_sch]
2025-01-02 powersim: finish PCB
    [powersim.kicad_pcb, powersim.kicad_sch]
2025-01-02 powersim: finish board
    [powersim.kicad_pcb]
2025-01-03 sensors: generate final production files
    [bom.csv, designators.csv, positions.csv, sensors.kicad_pcb]
2025-01-03 backplate: generate final production files
    [backplate.kicad_pcb, bom.csv, designators.csv, positions.csv]
2025-01-03 powersim: generate final production files
    [bom.csv, designators.csv, positions.csv, powersim.kicad_pcb]
2025-01-03 Revert kicad/modules/backplate/backplate.kicad_prl to aa3ca6f3f7ed60b4904834a44ccae3b66bebb62d
2025-01-03 revise production files
    [bom.csv, designators.csv, positions.csv, sensors.kicad_pcb]
2025-01-03 revise production files again
    [designators.csv, positions.csv, sensors.kicad_pcb]
2025-01-03 sensors: update vias under rp2040
    [designators.csv, positions.csv, sensors.kicad_pcb]
